adafruit/Adafruit-NeoDriver-STEMMA-QT-PCB/Adafruit NeoDriver STEMMA QT.brd

## EAGLE design Adafruit NeoDriver STEMMA QT.brd (2023-06-05)

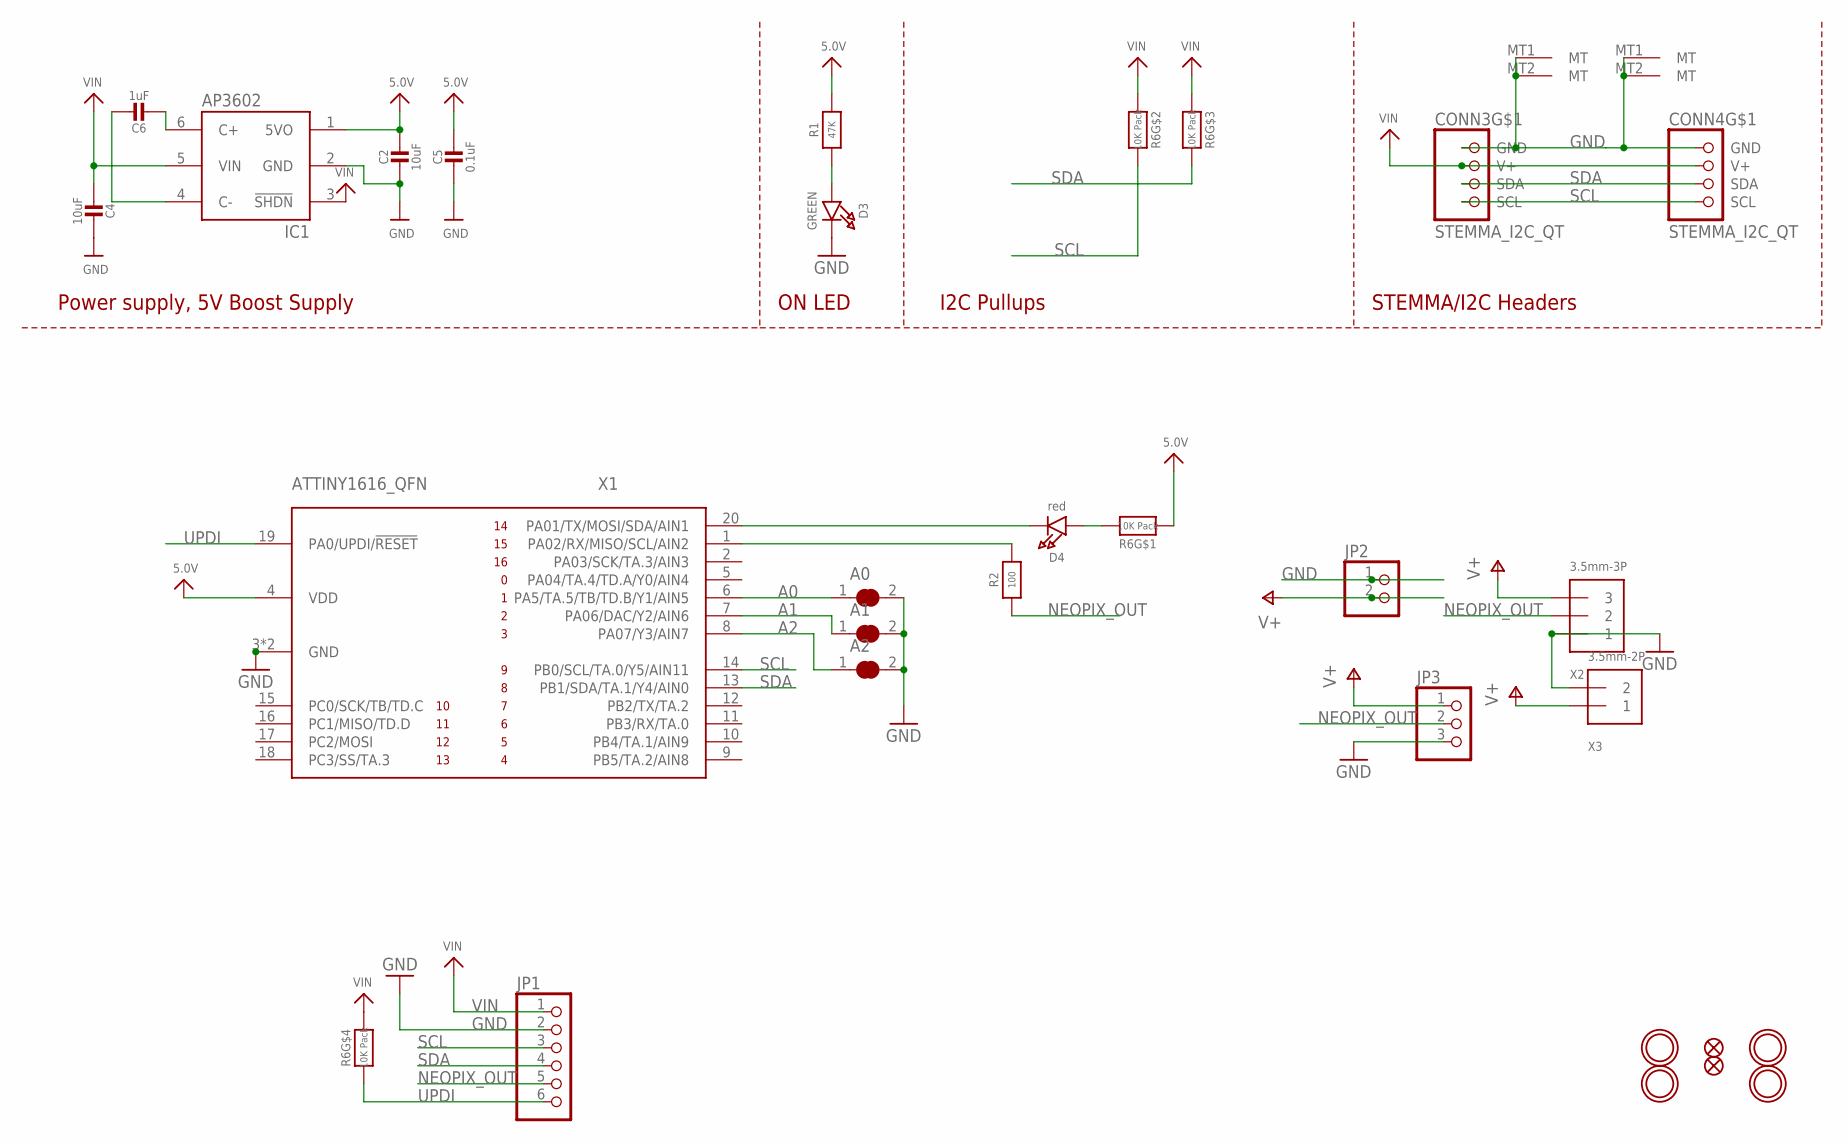
[picture p2: schematic Adafruit NeoDriver STEMMA QT.sch]

Parts:
A0, A1, A2: SOLDERJUMPER_CLOSED; SOLDERJUMPER_CLOSEDWIRE
C2, C4: 10uF; 0805-NO
C5: 0.1uF; 0603-NO
C6: 1uF; 0603-NO
CONN3, CONN4: STEMMA_I2C_QT; JST_SH4
D3: GREEN; CHIPLED_0603_NOOUTLINE
D4: red; CHIPLED_0603_NOOUTLINE
FID1, FID2: FIDUCIAL_1MM
IC1: AP3602; SOT23-6
JP1: HEADER-1X670MIL; 1X06_ROUND_70
JP2: HEADER-1X2ROUND; 1X02_ROUND
JP3: HEADER-1X3ROUND; 1X03_ROUND
R1: 47K; 0603-NO
R2: 100; 0603-NO
R6: 10K Pack; RESPACK_4X0603
U$1, U$6, U$9, U$18: MOUNTINGHOLE2.5; MOUNTINGHOLE_2.5_PLATED
X1: ATTINY1616_QFN; QFN20_3MM
X2: 3.5mm-3P; TERMBLOCK_1X3-3.5MM
X3: 3.5mm-2P; TERMBLOCK_1X2-3.5MM

Connections:
5.0V: C2.1, C5.1, IC1.1 (5VO), R1.2, R6.1, X1.4 (VDD)
A0: A0.1, X1.6 (PA5/TA.5/TB/TD.B/Y1/AIN5)
A1: A1.1, X1.7 (PA06/DAC/Y2/AIN6)
A2: A2.1, X1.8 (PA07/Y3/AIN7)
ACT: D4.C, X1.20 (PA01/TX/MOSI/SDA/AIN1)
GND: A0.2, A1.2, A2.2, C2.2, C4.2, C5.2, CONN3.1 (GND), CONN3.MT1 (MT), CONN3.MT2 (MT), CONN4.1 (GND), CONN4.MT1 (MT), CONN4.MT2 (MT), D3.C, IC1.2 (GND), JP1.2, JP2.1, JP3.3, X1.3 (GND), X1.PAD (GND), X2.1, X3.2
unnamed: D3.A, R1.1
unnamed: C6.2, IC1.6 (C+)
unnamed: C6.1, IC1.4 (C-)
unnamed: D4.A, R6.8 (2)
unnamed: R2.2, X1.1 (PA02/RX/MISO/SCL/AIN2)
NEOPIX_OUT: JP1.5, JP3.2, R2.1, X2.2
SCL: CONN3.4 (SCL), CONN4.4 (SCL), JP1.3, R6.7 (2), X1.14 (PB0/SCL/TA.0/Y5/AIN11)
SDA: CONN3.3 (SDA), CONN4.3 (SDA), JP1.4, R6.6 (2), X1.13 (PB1/SDA/TA.1/Y4/AIN0)
UPDI: JP1.6, R6.4 (1), X1.19 (PA0/UPDI/!RESET)
V+: JP2.2, JP3.1, X2.3, X3.1
VIN: C4.1, CONN3.2 (V+), CONN4.2 (V+), IC1.3 (!SHDN), IC1.5 (VIN), JP1.1, R6.2 (1), R6.3 (1), R6.5 (2)

Notes on the sheet:
I2C Pullups
STEMMA/I2C Headers
ON LED
Power supply, 5V Boost Supply

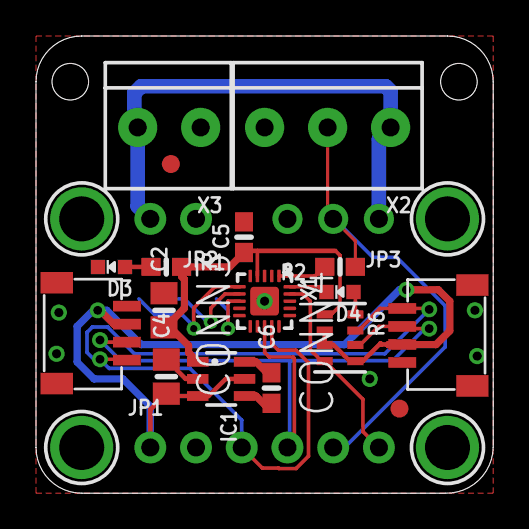
[picture p3: board Adafruit NeoDriver STEMMA QT.brd from above]

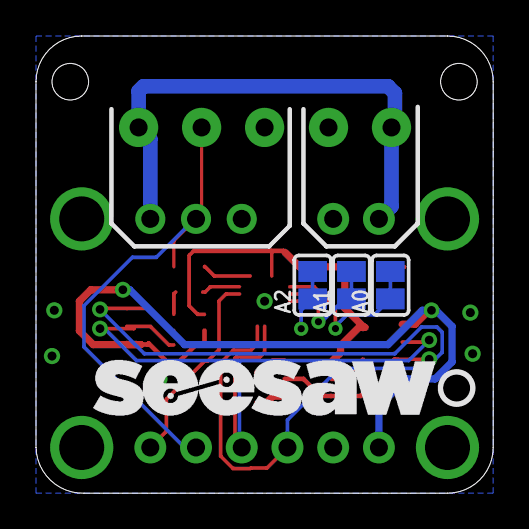
[picture p4: board Adafruit NeoDriver STEMMA QT.brd from below]

Board: 2 copper layers, 25.4 x 25.4 mm, 59 parts (17 on the bottom side), 17 nets.

Other parts of the board:
PLABEL0: PLABEL0
PLABEL1: PLABEL1
PLABEL2: PLABEL2
PLABEL3: PLABEL3
PLABEL4: PLABEL4
PLABEL5: PLABEL5
PLABEL6: PLABEL6
PLABEL7: PLABEL7
PLABEL8: PLABEL8
PLABEL9: PLABEL9
PLABEL10: PLABEL10
PLABEL11: PLABEL11
PLABEL12: PLABEL12
PLABEL13: PLABEL13
PLABEL14: PLABEL14
PLABEL15: PLABEL15
PLABEL16: PLABEL16
PLABEL17: PLABEL17
PLABEL18: PLABEL18
PLABEL19: PLABEL19
PLABEL20: PLABEL20
PLABEL21: PLABEL21
PLABEL22: PLABEL22
PLABEL23: PLABEL23
PLABEL24: PLABEL24
PLABEL25: PLABEL25
PLABEL26: PLABEL26
PLABEL27: PLABEL27
PLABEL28: PLABEL28
PLABEL29: PLABEL29
U$7: SEESAW_LOGO
U$12: PCBFEAT-REV-040
